profdc9/STM32F4surface/STM32alt-bare.png

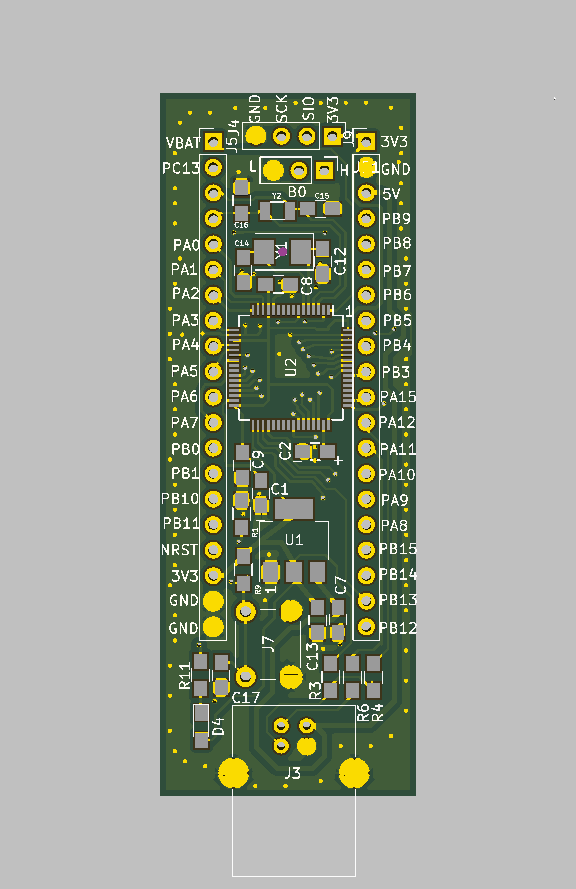
STM32alt-bare.png
