profdc9/STM32F4surface/STM32alt-populated.png

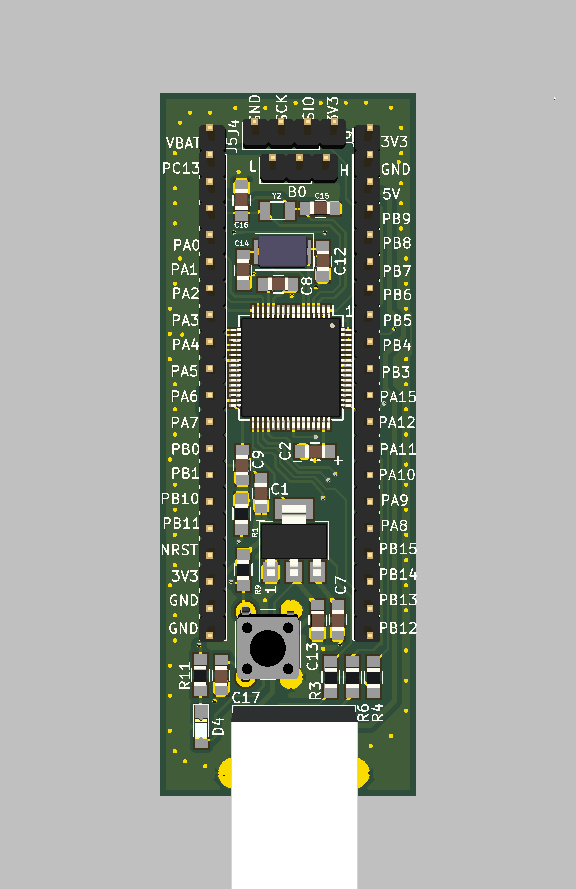
STM32alt-populated.png
