profdc9/STM32F4surface/STM32alt-BOM-STM32F1.xlsx

Comment | Designator | Footprint | LCSC
0R | C1,C2 | Capacitors_SMD:C_0805_HandSoldering | C17477
20 pF | C12,C14,C15,C16 | Capacitors_SMD:C_0805_HandSoldering | C1798
10 nF | C17 | Capacitors_SMD:C_0805_HandSoldering | C1710
1 uF | C7,C13 | Capacitors_SMD:C_0805_HandSoldering | C28323
0.1 uF | C8,C9 | Capacitors_SMD:C_0805_HandSoldering | C49678
LED | D4 | LEDs:LED_0805_HandSoldering | C84256
USB_B | J3 | Connectors:USB_B
Conn_01x04 | J4 | Pin_Headers:Pin_Header_Straight_1x04_Pitch2.54mm
Conn_01x20 | J5,J9 | Pin_Headers:Pin_Header_Straight_1x20_Pitch2.54mm
Conn_01x02 | J7 | Buttons_Switches_THT:SW_PUSH_6mm
Jumper_NC_Dual | JP1 | Pin_Headers:Pin_Header_Straight_1x03_Pitch2.54mm
100k | R1 | Resistors_SMD:R_0805_HandSoldering | C17407
470R | R11 | Resistors_SMD:R_0805_HandSoldering | C17710
1.5k | R3,R9 | Resistors_SMD:R_0805_HandSoldering | C4310
22R | R4,R6 | Resistors_SMD:R_0805_HandSoldering | C17561
LM1117-3.3 | U1 | TO_SOT_Packages_SMD:SOT-223-3_TabPin2 | C6186
STM32F103RET6 | U2 | Housings_QFP:LQFP-64_10x10mm_Pitch0.5mm | C8322
8 MHz | Y1 | Crystals:Crystal_SMD_5032-2pin_5.0x3.2mm | C115962
Crystal | Y2 | Crystals:Crystal_SMD_3215-2pin_3.2x1.5mm | C32346
