profdc9/STM32F4surface/STM32altSchematic.pdf

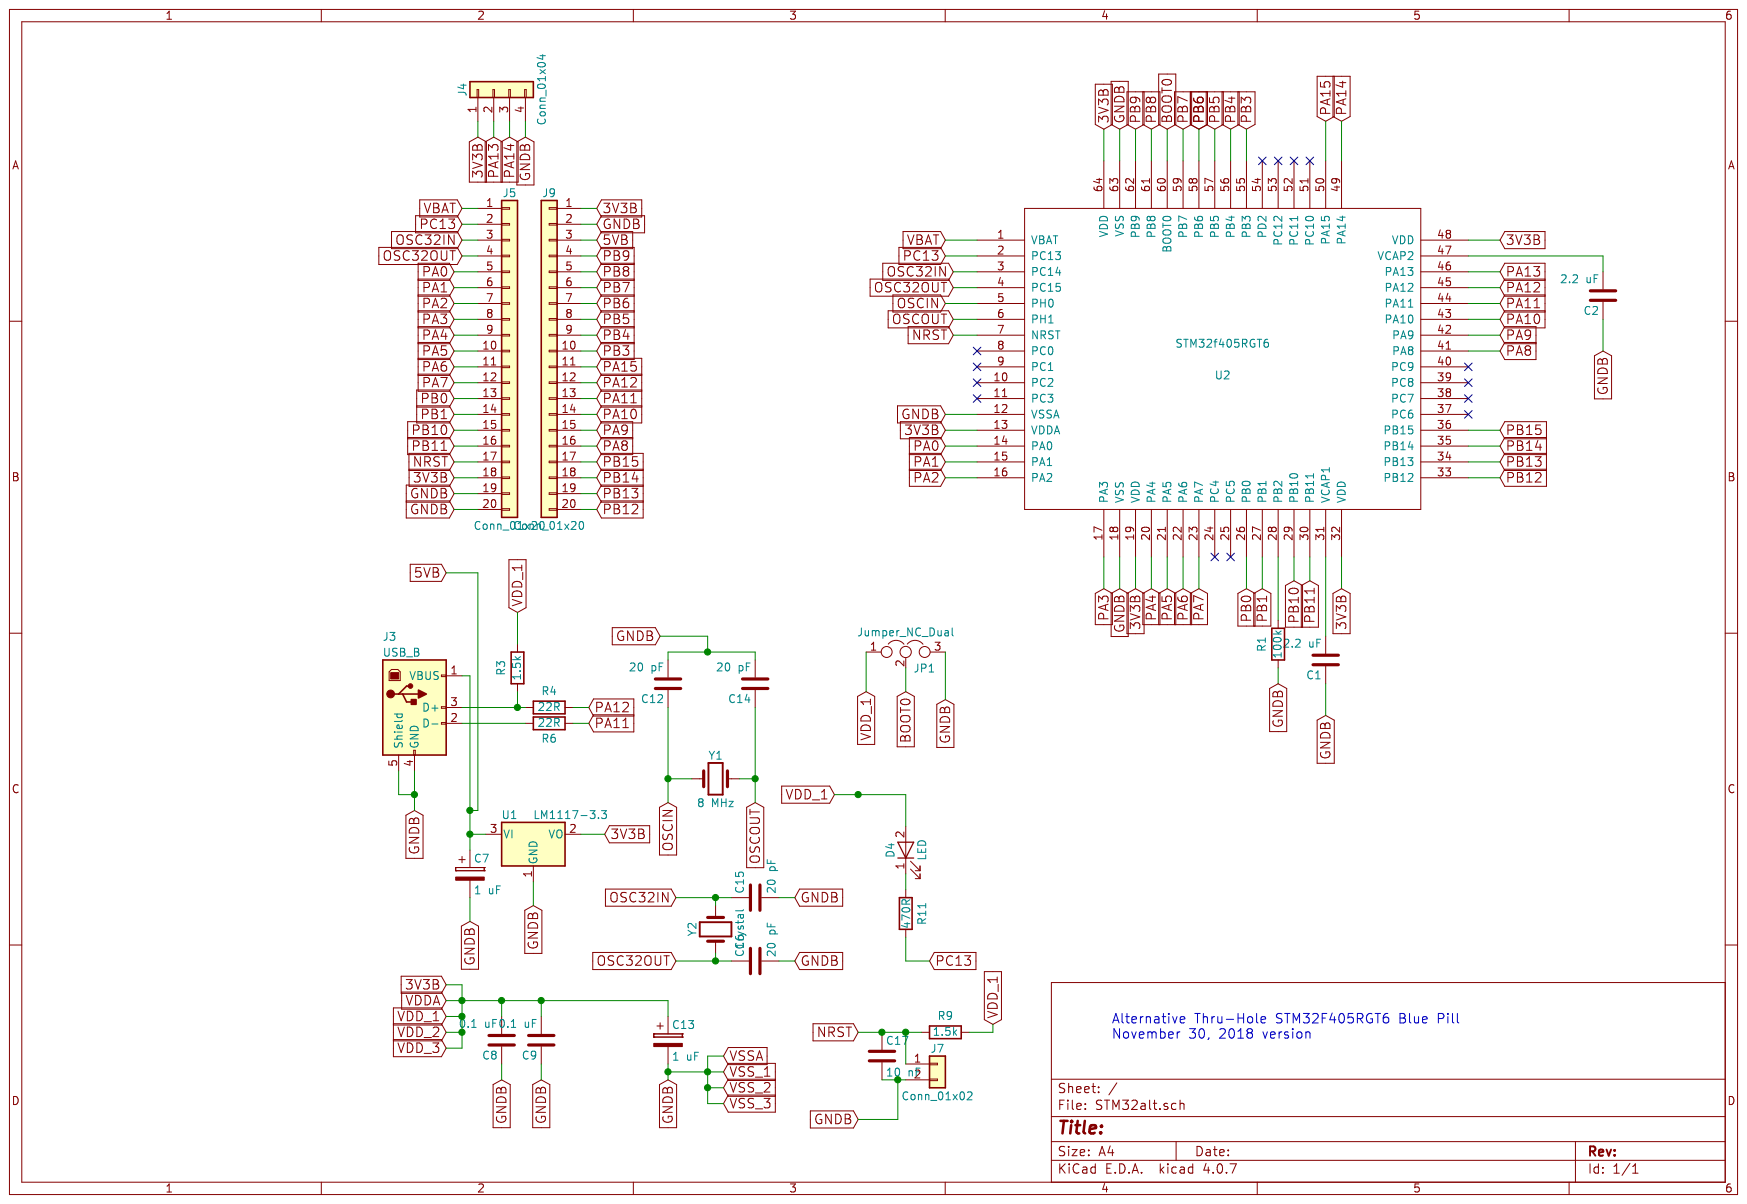
[picture p3: page 1]
