profdc9/STM32F4surface/STM32alt.kicad_pcb

## KiCad design STM32alt.kicad_pcb (2020-10-07)

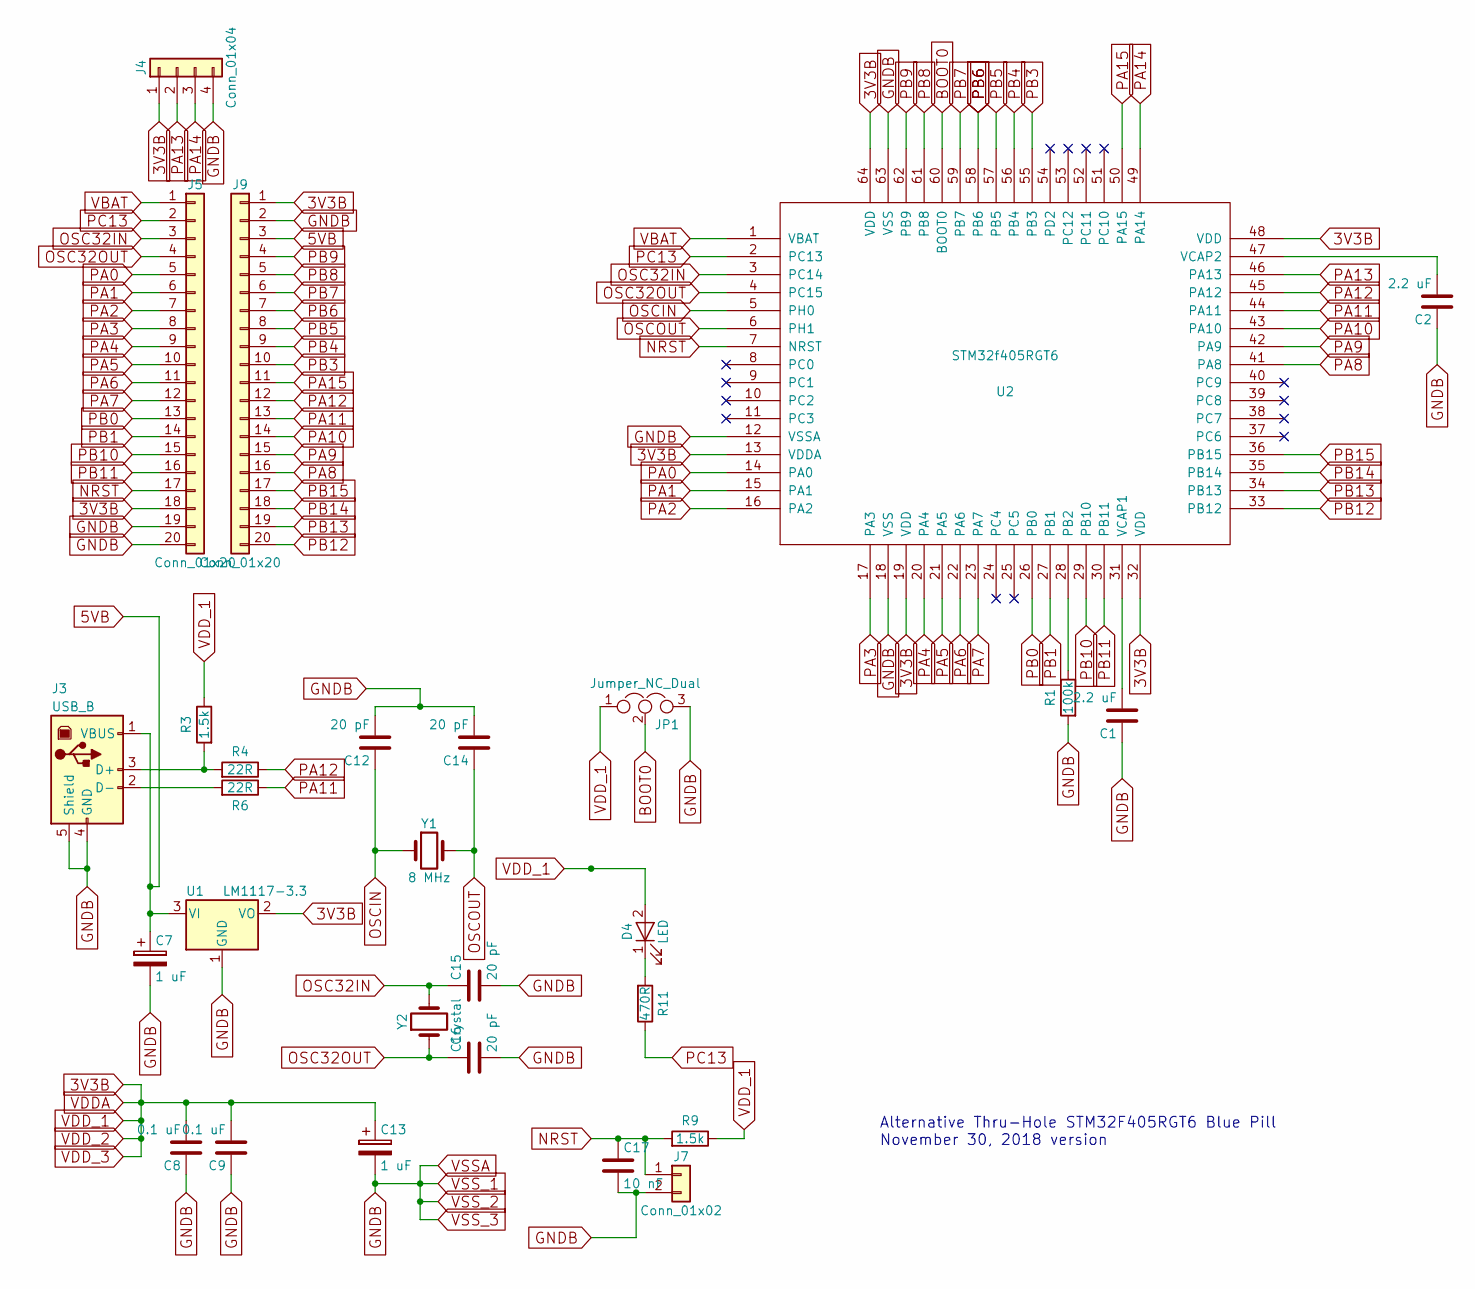
[picture p4: schematic STM32alt.sch]

Parts:
C1, C2: 2.2 uF; C_0805_HandSoldering; LCSC C49217
C7, C13: 1 uF; C_0805_HandSoldering; LCSC C28323
C8, C9: 0.1 uF; C_0805_HandSoldering; LCSC C49678
C12, C14, C15, C16: 20 pF; C_0805_HandSoldering; LCSC C1798
C17: 10 nF; C_0805_HandSoldering; LCSC C1710
D4: LED; LED_0805_HandSoldering; LCSC C84256
J3: USB_B
J4: Conn_01x04; Pin_Header_Straight_1x04_Pitch2.54mm
J5, J9: Conn_01x20; Pin_Header_Straight_1x20_Pitch2.54mm
J7: Conn_01x02; SW_PUSH_6mm
JP1: Jumper_NC_Dual; Pin_Header_Straight_1x03_Pitch2.54mm
R1: 100k; R_0805_HandSoldering; LCSC C17407
R3, R9: 1.5k; R_0805_HandSoldering; LCSC C4310
R4, R6: 22R; R_0805_HandSoldering; LCSC C17561
R11: 470R; R_0805_HandSoldering; LCSC C17710
U1: LM1117-3.3; SOT-223-3_TabPin2; LCSC C6186
U2: STM32f405RGT6; LQFP-64_10x10mm_Pitch0.5mm; LCSC C15742
Y1: 8 MHz; Crystal_SMD_5032-2pin_5.0x3.2mm; LCSC C115962
Y2: Crystal; Crystal_SMD_3215-2pin_3.2x1.5mm; LCSC C32346

Connections:
3V3B: C8.2, C9.2, C13.1, D4.2 (A), J4.1, J5.18, J9.1, JP1.1, R3.1, R9.1, U1.2 (VO), U2.13 (VDDA), U2.19 (VDD), U2.32 (VDD), U2.48 (VDD), U2.64 (VDD)
5VB: C7.1, J3.1 (VBUS), J9.3, U1.3 (VI)
BOOT0: JP1.2, U2.60 (BOOT0)
GNDB: C1.1, C2.1, C7.2, C8.1, C9.1, C12.2, C13.2, C14.2, C15.2, C16.2, C17.2, J3.4 (GND), J3.5 (Shield), J4.4, J5.19, J5.20, J7.2, J9.2, JP1.3, R1.2, U1.1 (GND), U2.12 (VSSA), U2.18 (VSS), U2.63 (VSS)
NRST: C17.1, J5.17, J7.1, R9.2, U2.7 (NRST)
unnamed: C1.2, U2.31 (VCAP1)
unnamed: C2.2, U2.47 (VCAP2)
unnamed: D4.1 (K), R11.2
unnamed: J3.2 (D-), R6.2
unnamed: J3.3 (D+), R3.2, R4.2
unnamed: R1.1, U2.28 (PB2)
OSC32IN: C15.1, J5.3, U2.3 (PC14), Y2.2
OSC32OUT: C16.1, J5.4, U2.4 (PC15), Y2.1
OSCIN: C12.1, U2.5 (PH0), Y1.1
OSCOUT: C14.1, U2.6 (PH1), Y1.2
PA0: J5.5, U2.14 (PA0)
PA1: J5.6, U2.15 (PA1)
PA2: J5.7, U2.16 (PA2)
PA3: J5.8, U2.17 (PA3)
PA4: J5.9, U2.20 (PA4)
PA5: J5.10, U2.21 (PA5)
PA6: J5.11, U2.22 (PA6)
PA7: J5.12, U2.23 (PA7)
PA8: J9.16, U2.41 (PA8)
PA9: J9.15, U2.42 (PA9)
PA10: J9.14, U2.43 (PA10)
PA11: J9.13, R6.1, U2.44 (PA11)
PA12: J9.12, R4.1, U2.45 (PA12)
PA13: J4.2, U2.46 (PA13)
PA14: J4.3, U2.49 (PA14)
PA15: J9.11, U2.50 (PA15)
PB0: J5.13, U2.26 (PB0)
PB1: J5.14, U2.27 (PB1)
PB3: J9.10, U2.55 (PB3)
PB4: J9.9, U2.56 (PB4)
PB5: J9.8, U2.57 (PB5)
PB6: J9.7, U2.58 (PB6)
PB7: J9.6, U2.59 (PB7)
PB8: J9.5, U2.61 (PB8)
PB9: J9.4, U2.62 (PB9)
PB10: J5.15, U2.29 (PB10)
PB11: J5.16, U2.30 (PB11)
PB12: J9.20, U2.33 (PB12)
PB13: J9.19, U2.34 (PB13)
PB14: J9.18, U2.35 (PB14)
PB15: J9.17, U2.36 (PB15)
PC13: J5.2, R11.1, U2.2 (PC13)
VBAT: J5.1, U2.1 (VBAT)

Notes on the sheet:
Alternative Thru-Hole STM32F405RGT6 Blue Pill November 30, 2018 version

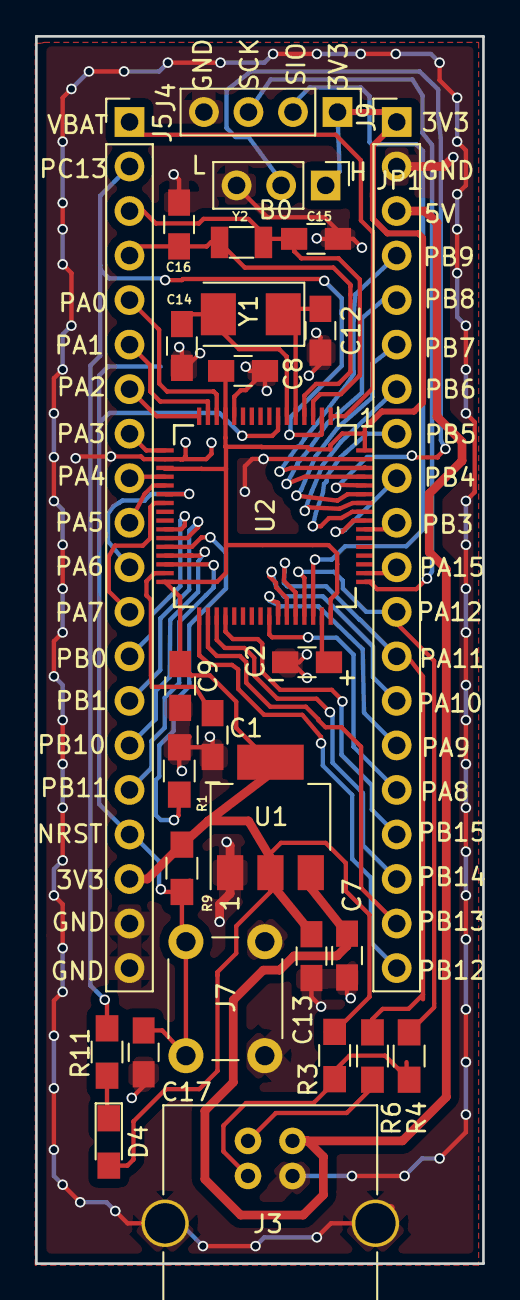
[picture p5: board STM32alt.kicad_pcb from above]

Board: 2 copper layers, 25.5 x 70.0 mm, 28 parts (0 on the bottom side), 48 nets.
